ArcaneNibble/hexpansion-headphones/README.md

# EMFCamp Hexpansion -- headphone jack

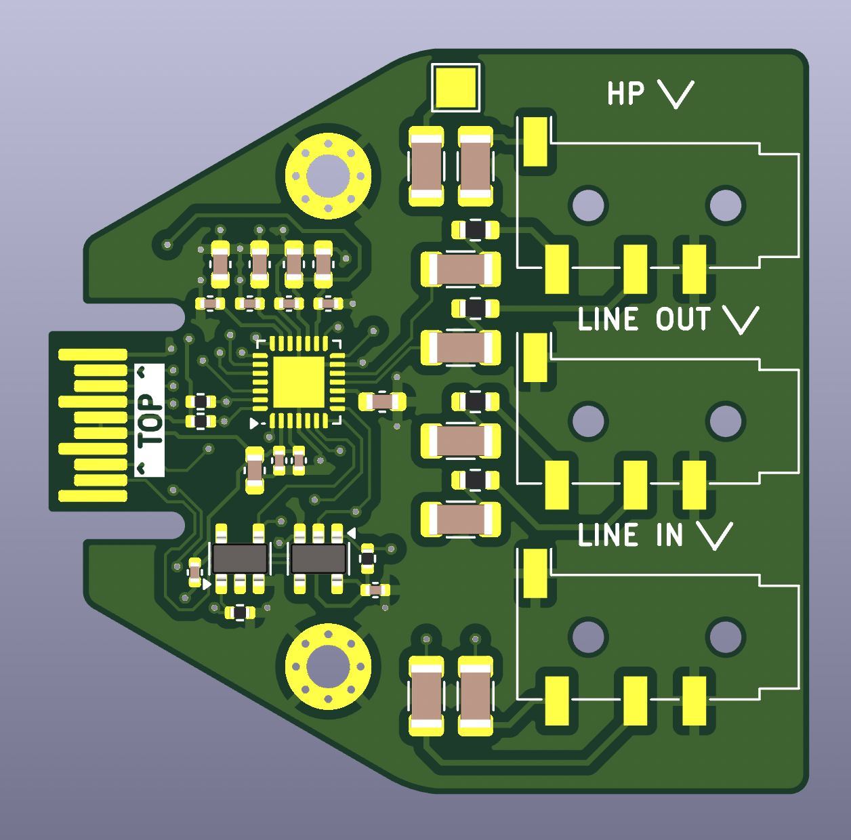
[picture p1: front.png]
front render
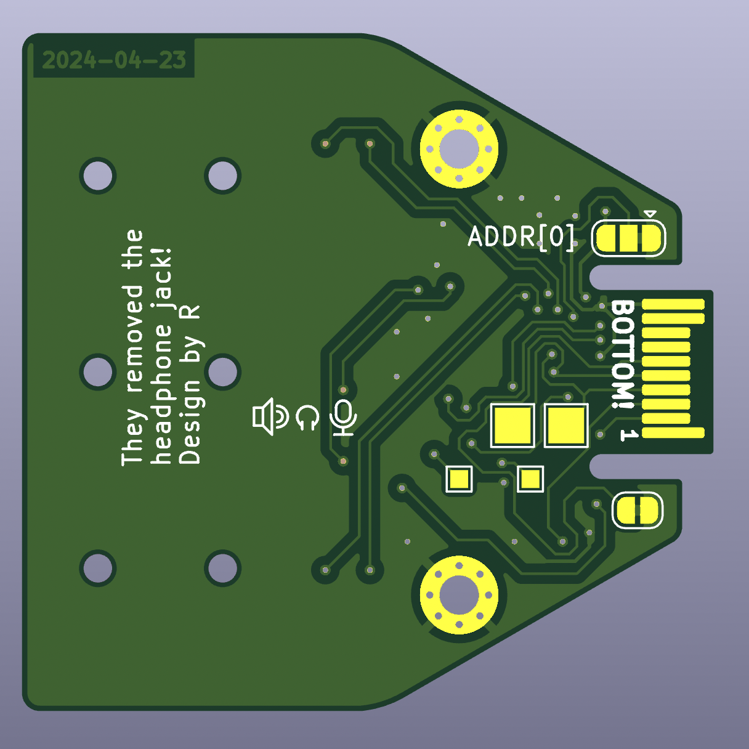
[picture p2: back.png]
back render
 

ES8388 headphone codec chip
