ArcaneNibble/hexpansion-headphones/revA-sch.pdf

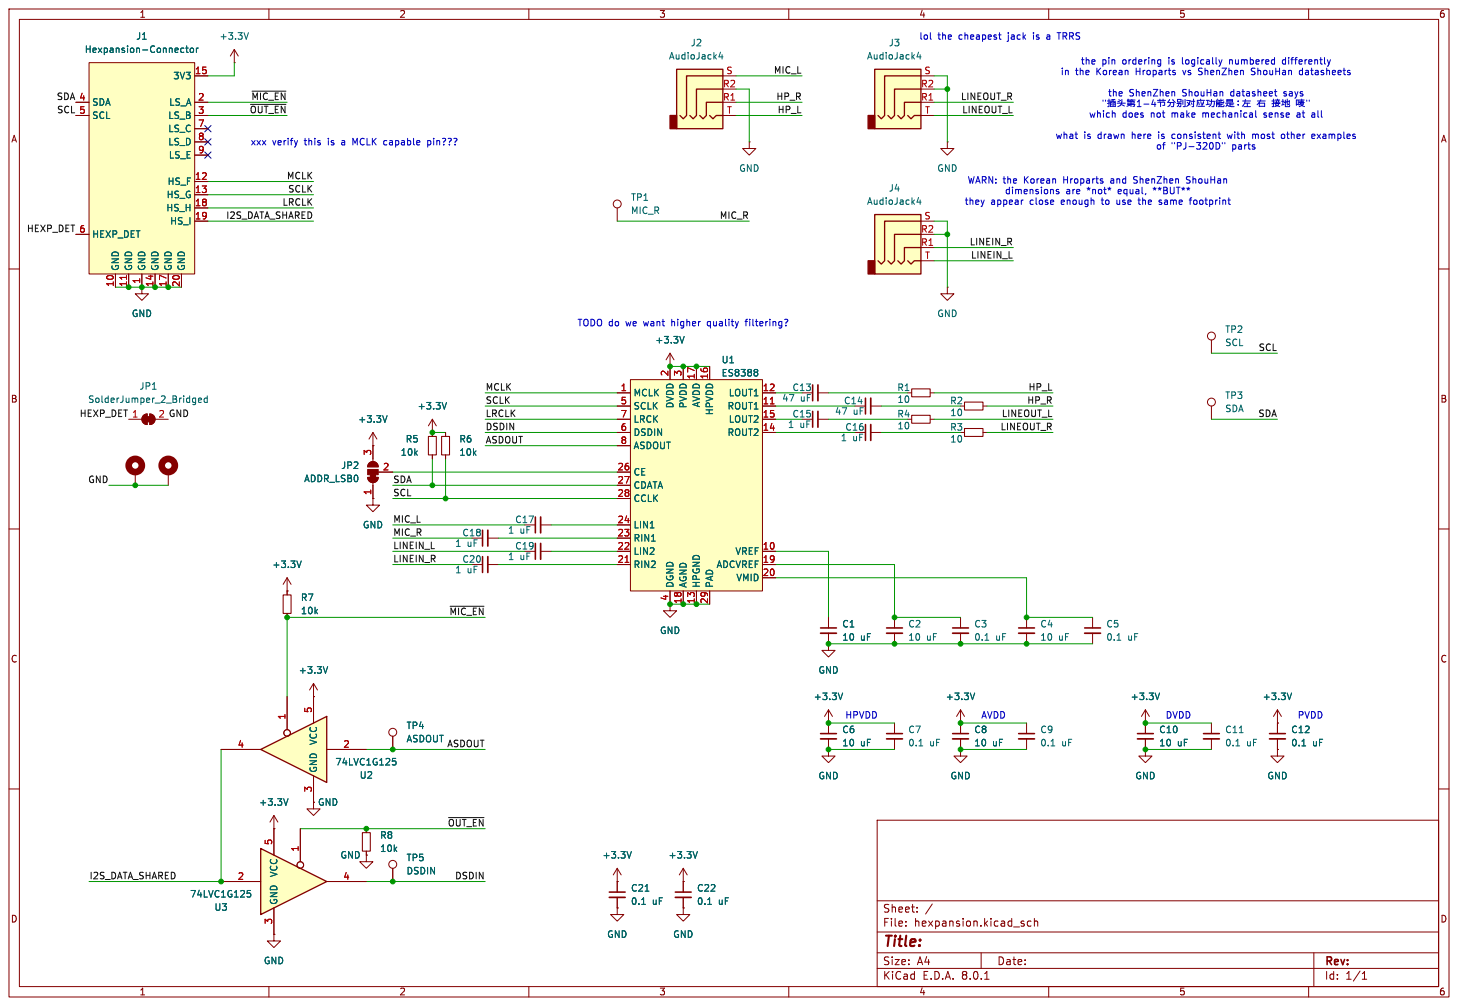
[picture p3: page 1]

they appear close enough to use the same footprint

Id: 1/1 Title: File: hexpansion.kicad_sch Sheet: / GND
