ArcaneNibble/hexpansion-headphones/(commit log)

2024-04-03 Initial import
    [hexpansion.kicad_pcb, hexpansion.kicad_sch]
2024-04-03 re-save in kicad 8
    [hexpansion.kicad_pcb, hexpansion.kicad_sch]
2024-04-03 extract out hexpansion parts to custom library
    [hexpansion.kicad_pcb, hexpansion.kicad_sch]
2024-04-04 add codec symbol
    [hexpansion.kicad_sch]
2024-04-04 rough sch
    [hexpansion.kicad_sch]
2024-04-04 footprint for codec
2024-04-04 rough everything
    [hexpansion.kicad_pcb, hexpansion.kicad_sch]
2024-04-04 rough route
    purposely ignore extra gnd
    [hexpansion.kicad_pcb, hexpansion.kicad_sch]
2024-04-04 more small tweaks
    [hexpansion.kicad_pcb]
2024-04-23 doodles, fab layer cleanup
    [hexpansion.kicad_pcb, hexpansion.kicad_sch]
2024-04-23 generate fab outputs
    [hexpansion.kicad_pcb, hexpansion.kicad_sch]
2024-04-24 Add rev A schematic as PDF
